CheimaAmmar/remotesign-lab/document-test.txt

Document de test pour la signature électronique
