CheimaAmmar/remotesign-lab/hardware/fabrication/schematic.pdf

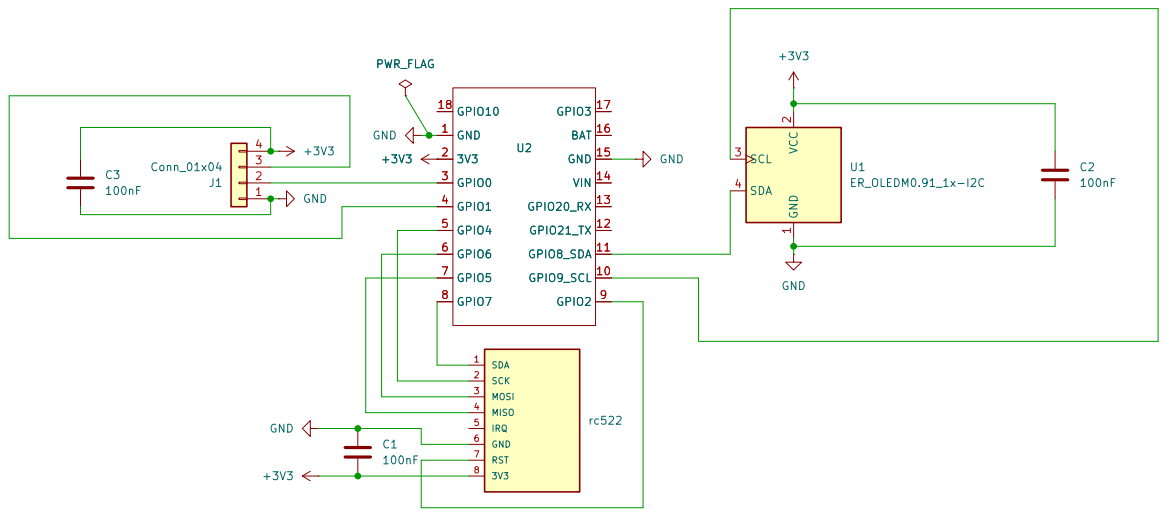
[picture p6: page 1]

Size: A4 | Rev:
KiCad E.D.A. 10.0.5 | Id: 1/1
