CheimaAmmar/remotesign-lab/hardware/fabrication/copper-layout-inverted.pdf

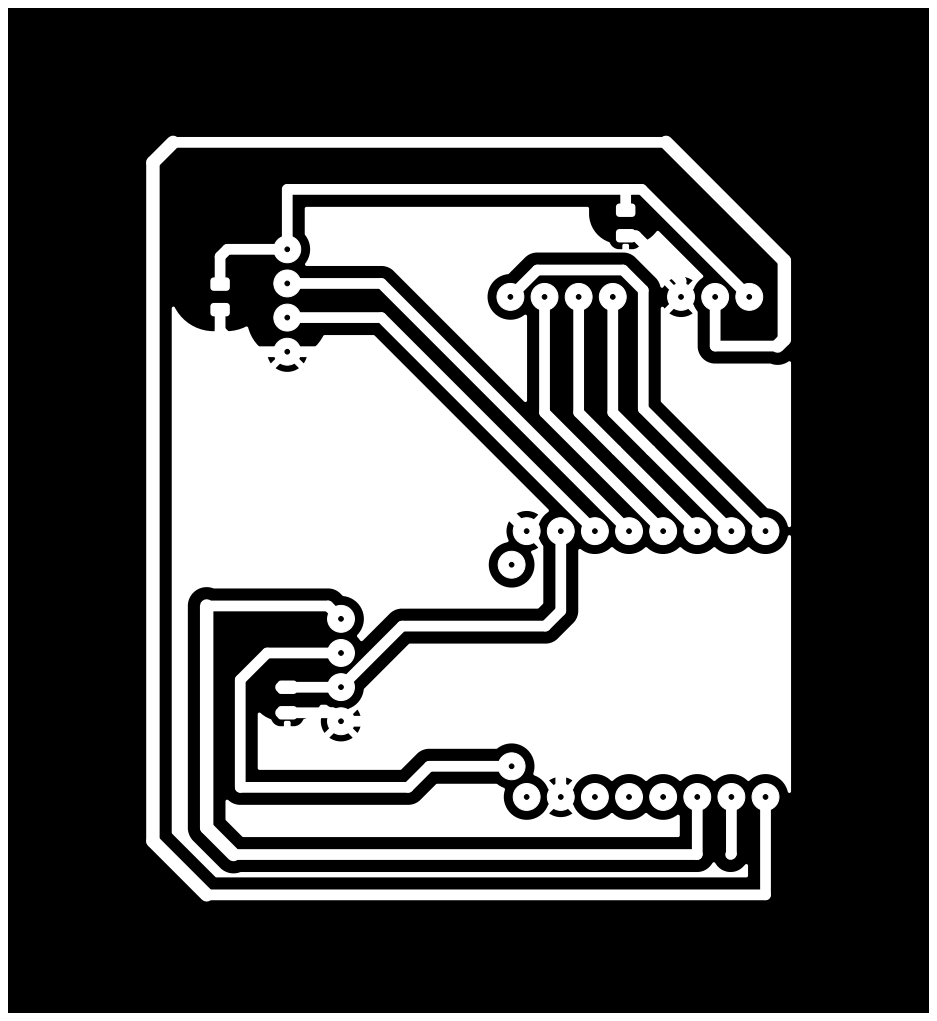
[picture p7: page 1]
