CheimaAmmar/remotesign-lab/hardware/kicad/remotesign_lab.kicad_pcb

## KiCad design hardware/kicad/remotesign_lab.kicad_pcb (2026-09-13)

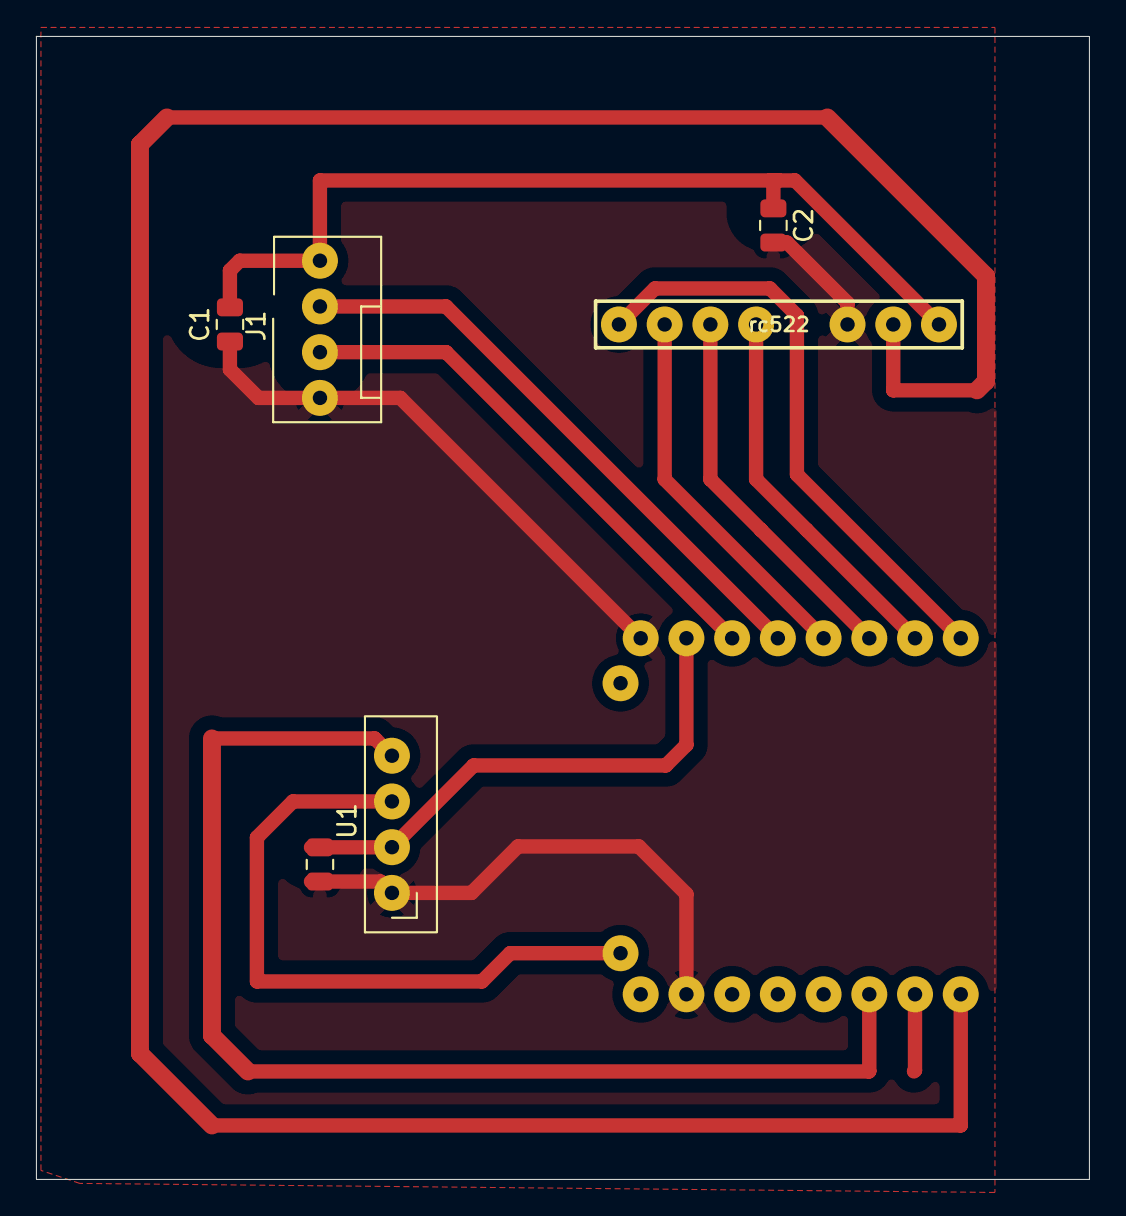
[picture p8: board remotesign_lab.kicad_pcb from above]

Board: 2 copper layers, 58.5 x 63.5 mm, 7 parts (0 on the bottom side), 11 nets.

Parts:
C1, C2, C3: 100nF; C_0805_2012Metric
J1: Conn_01x04; FanPinHeader_1x04_P2.54mm_Vertical
U1: ER_OLEDM0.91_1x-I2C
U2: BEETLE_ESP32_C3_DFR0868
rc522: RFID-RC522

Connections:
+3V3: C1.2, C2.1, C3.1, J1.4, U1.2 (VCC), U2.2 (3V3), rc522.8 (3V3)
GND: C1.1, C2.2, C3.2, J1.1, U1.1 (GND), U2.1 (GND), U2.15 (GND), rc522.6 (GND)
unnamed: J1.2, U2.3 (GPIO0)
unnamed: J1.3, U2.4 (GPIO1)
unnamed: U1.3 (SCL), U2.17 (GPIO3)
unnamed: U1.4 (SDA), U2.11 (GPIO8_SDA)
unnamed: U2.9 (GPIO2), rc522.7 (RST)
unnamed: U2.5 (GPIO4), rc522.2 (SCK)
unnamed: U2.7 (GPIO5), rc522.4 (MISO)
unnamed: U2.6 (GPIO6), rc522.3 (MOSI)
unnamed: U2.8 (GPIO7), rc522.1 (SDA)
