CheimaAmmar/remotesign-lab/app/services/signature_request_service.py

import logging
import uuid

from datetime import datetime, timedelta, timezone

from sqlalchemy import func, select, update
from sqlalchemy.exc import SQLAlchemyError
from sqlalchemy.orm import Session

from app.models import (
    AuthenticationSession,
    Device,
    Document,
    DocumentSignature,
    SignatureRequest,
    SignatureRequestStatus,
)


logger = logging.getLogger(__name__)

SIGNATURE_REQUEST_TTL_SECONDS = 15 * 60

EXPIRABLE_SIGNATURE_REQUEST_STATUSES = (
    SignatureRequestStatus.PENDING,
    SignatureRequestStatus.CLAIMED,
)


def utc_now() -> datetime:
    return datetime.now(timezone.utc)


def _device_queue_lock_key(device_id: uuid.UUID) -> int:
    # PostgreSQL advisory locks accept a signed BIGINT. UUID entropy is
    # retained in the low 63 bits without risking an integer overflow.
    return device_id.int & ((1 << 63) - 1)


def _expire_if_needed(
    signature_request: SignatureRequest,
    *,
    now: datetime,
    database: Session | None = None,
) -> bool:
    if (
        signature_request.status
        not in EXPIRABLE_SIGNATURE_REQUEST_STATUSES
        or signature_request.expires_at > now
    ):
        return False

    signature_request.status = SignatureRequestStatus.EXPIRED
    signature_request.failure_detail = (
        "Signature request expired"
    )
    signature_request.completed_at = now
    signature_request.updated_at = now

    if database is not None:
        # Local import keeps the queue service independent at import time
        # while ensuring expiration and its audit evidence share one
        # transaction.
        from app.services.audit_service import add_audit_event

        add_audit_event(
            database,
            event_type="SIGNATURE_REQUEST_EXPIRED",
            outcome="FAILURE",
            actor_type="SYSTEM",
            user_id=signature_request.user_id,
            device_id=signature_request.device_id,
            document_id=signature_request.document_id,
            signature_request_id=signature_request.id,
            failure_code="REQUEST_EXPIRED",
            detail="Signature request expired",
        )

    return True


def create_signature_request(
    database: Session,
    *,
    owner_session_id: str,
    user_id: uuid.UUID,
    device: Device,
    document: Document,
    consented_at: datetime | None = None,
    consent_version: str | None = None,
) -> SignatureRequest:
    document_user_id = getattr(document, "user_id", None)

    if (
        document_user_id is not None
        and document_user_id != user_id
    ):
        raise ValueError(
            "Document does not belong to the requesting user"
        )

    now = utc_now()
    signature_request = SignatureRequest(
        owner_session_id=owner_session_id,
        user_id=user_id,
        device_id=device.id,
        document_id=document.id,
        document_hash=document.document_hash,
        decision="APPROVE",
        consented_at=consented_at,
        consent_version=consent_version,
        status=SignatureRequestStatus.PENDING,
        expires_at=(
            now
            + timedelta(
                seconds=SIGNATURE_REQUEST_TTL_SECONDS
            )
        ),
        updated_at=now,
    )

    database.add(signature_request)

    return signature_request


def expire_signature_requests(
    database: Session,
    *,
    device_id: uuid.UUID | None = None,
    now: datetime | None = None,
) -> int:
    current_time = now or utc_now()
    conditions = [
        SignatureRequest.status.in_(
            EXPIRABLE_SIGNATURE_REQUEST_STATUSES
        ),
        SignatureRequest.expires_at <= current_time,
    ]

    if device_id is not None:
        conditions.append(
            SignatureRequest.device_id == device_id
        )

    if isinstance(database, Session):
        expired_requests = list(
            database.scalars(
                select(SignatureRequest)
                .where(*conditions)
                .order_by(
                    SignatureRequest.created_at.asc(),
                    SignatureRequest.id.asc(),
                )
                .with_for_update(skip_locked=True)
            ).all()
        )

        for signature_request in expired_requests:
            _expire_if_needed(
                signature_request,
                now=current_time,
                database=database,
            )

        return len(expired_requests)

    # Lightweight compatibility path for isolated unit-test doubles.
    result = database.execute(
        update(SignatureRequest)
        .where(*conditions)
        .values(
            status=SignatureRequestStatus.EXPIRED,
            failure_detail="Signature request expired",
            completed_at=current_time,
            updated_at=current_time,
        )
    )

    return int(result.rowcount or 0)


def claim_next_signature_request(
    database: Session,
    *,
    device: Device,
) -> SignatureRequest | None:
    now = utc_now()

    # Serializes queue pollers for one physical device without locking
    # the devices row also updated by the existing authentication flows.
    # The lock is released automatically with this transaction.
    database.execute(
        select(
            func.pg_advisory_xact_lock(
                _device_queue_lock_key(device.id)
            )
        )
    )

    expire_signature_requests(
        database,
        device_id=device.id,
        now=now,
    )

    in_flight_request = database.scalar(
        select(SignatureRequest)
        .where(
            SignatureRequest.device_id == device.id,
            SignatureRequest.status.in_(
                (
                    SignatureRequestStatus.CLAIMED,
                    SignatureRequestStatus.AUTHENTICATING,
                    SignatureRequestStatus.AUTHENTICATED,
                )
            ),
        )
        .order_by(
            SignatureRequest.claimed_at.asc(),
            SignatureRequest.created_at.asc(),
            SignatureRequest.id.asc(),
        )
        .with_for_update()
        .limit(1)
    )

    if in_flight_request is not None:
        # Never deliver a CLAIMED request a second time. The device must
        # finish or explicitly fail its current request before polling the
        # next FIFO item.
        return None

    signature_request = database.scalar(
        select(SignatureRequest)
        .where(
            SignatureRequest.device_id == device.id,
            SignatureRequest.status
            == SignatureRequestStatus.PENDING,
            SignatureRequest.expires_at > now,
        )
        .order_by(
            SignatureRequest.created_at.asc(),
            SignatureRequest.id.asc(),
        )
        .with_for_update(skip_locked=True)
        .limit(1)
    )

    if signature_request is None:
        return None

    signature_request.status = SignatureRequestStatus.CLAIMED
    signature_request.claimed_at = now
    signature_request.updated_at = now

    return signature_request


def get_owned_signature_request(
    database: Session,
    *,
    request_id: uuid.UUID,
    owner_session_id: str,
) -> SignatureRequest | None:
    signature_request = database.scalar(
        select(SignatureRequest)
        .where(
            SignatureRequest.id == request_id,
            SignatureRequest.owner_session_id
            == owner_session_id,
        )
        .with_for_update()
    )

    if signature_request is None:
        return None

    now = utc_now()

    _expire_if_needed(
        signature_request,
        now=now,
        database=database,
    )

    return signature_request


def get_user_signature_request(
    database: Session,
    *,
    request_id: uuid.UUID,
    user_id: uuid.UUID,
) -> SignatureRequest | None:
    signature_request = database.scalar(
        select(SignatureRequest)
        .where(
            SignatureRequest.id == request_id,
            SignatureRequest.user_id == user_id,
        )
        .with_for_update()
    )

    if signature_request is None:
        return None

    _expire_if_needed(
        signature_request,
        now=utc_now(),
        database=database,
    )

    return signature_request


def get_latest_signature_request_for_document(
    database: Session,
    *,
    document_id: uuid.UUID,
) -> SignatureRequest | None:
    """Return the latest request for ADMIN read-only monitoring."""
    signature_request = database.scalar(
        select(SignatureRequest)
        .where(
            SignatureRequest.document_id == document_id,
        )
        .order_by(
            SignatureRequest.created_at.desc(),
            SignatureRequest.id.desc(),
        )
        .limit(1)
    )

    return signature_request


def attach_authentication_session(
    database: Session,
    *,
    device_id: uuid.UUID,
    document_id: uuid.UUID,
    document_hash: str,
    decision: str,
    authentication_session: AuthenticationSession,
) -> SignatureRequest | None:
    now = utc_now()

    if (
        authentication_session.device_id != device_id
        or authentication_session.document_id != document_id
        or authentication_session.document_hash != document_hash
        or authentication_session.decision != decision
    ):
        return None

    signature_request = database.scalar(
        select(SignatureRequest)
        .where(
            SignatureRequest.device_id == device_id,
            SignatureRequest.document_id == document_id,
            SignatureRequest.document_hash == document_hash,
            SignatureRequest.decision == decision,
            SignatureRequest.status.in_(
                (
                    SignatureRequestStatus.CLAIMED,
                )
            ),
            SignatureRequest.authentication_session_id.is_(
                None
            ),
        )
        .order_by(
            SignatureRequest.claimed_at.asc(),
            SignatureRequest.created_at.asc(),
        )
        .with_for_update()
        .limit(1)
    )

    if signature_request is None:
        return None

    if _expire_if_needed(
        signature_request,
        now=now,
        database=database,
    ):
        return signature_request

    signature_request.authentication_session_id = (
        authentication_session.id
    )
    signature_request.status = (
        SignatureRequestStatus.AUTHENTICATING
    )
    signature_request.authentication_started_at = now
    signature_request.updated_at = now

    return signature_request


def mark_signature_request_authenticated(
    database: Session,
    *,
    authentication_session_id: uuid.UUID,
) -> SignatureRequest | None:
    signature_request = database.scalar(
        select(SignatureRequest)
        .where(
            SignatureRequest.authentication_session_id
            == authentication_session_id,
        )
        .with_for_update()
    )

    if signature_request is None:
        return None

    now = utc_now()

    if _expire_if_needed(
        signature_request,
        now=now,
        database=database,
    ):
        return signature_request

    if (
        signature_request.status
        == SignatureRequestStatus.AUTHENTICATING
    ):
        signature_request.status = (
            SignatureRequestStatus.AUTHENTICATED
        )
        signature_request.authenticated_at = now
        signature_request.updated_at = now

    return signature_request


def mark_signature_request_signed(
    database: Session,
    *,
    authentication_session_id: uuid.UUID,
    signature: DocumentSignature,
) -> SignatureRequest | None:
    signature_request = database.scalar(
        select(SignatureRequest)
        .where(
            SignatureRequest.authentication_session_id
            == authentication_session_id,
        )
        .with_for_update()
    )

    if signature_request is None:
        return None

    if (
        signature.session_id != authentication_session_id
        or signature_request.document_id
        != signature.document_id
        or signature_request.device_id != signature.device_id
        or signature_request.document_hash
        != signature.document_hash
    ):
        return signature_request

    now = utc_now()

    if _expire_if_needed(
        signature_request,
        now=now,
        database=database,
    ):
        return signature_request

    if (
        signature_request.status
        == SignatureRequestStatus.AUTHENTICATED
    ):
        signature_request.status = SignatureRequestStatus.SIGNED
        signature_request.signature_id = signature.id
        signature_request.completed_at = now
        signature_request.updated_at = now

    return signature_request


def mark_signature_request_failed(
    database: Session,
    *,
    request_id: uuid.UUID,
    device_id: uuid.UUID,
    failure_detail: str,
) -> SignatureRequest | None:
    signature_request = database.scalar(
        select(SignatureRequest)
        .where(
            SignatureRequest.id == request_id,
            SignatureRequest.device_id == device_id,
        )
        .with_for_update()
    )

    if signature_request is None:
        return None

    now = utc_now()

    if _expire_if_needed(
        signature_request,
        now=now,
        database=database,
    ):
        return signature_request

    if signature_request.status in (
        SignatureRequestStatus.CLAIMED,
        SignatureRequestStatus.AUTHENTICATING,
        SignatureRequestStatus.AUTHENTICATED,
    ):
        signature_request.status = SignatureRequestStatus.FAILED
        signature_request.failure_detail = failure_detail[:255]
        signature_request.completed_at = now
        signature_request.updated_at = now

    return signature_request


def mark_signature_request_failed_by_session(
    database: Session,
    *,
    authentication_session_id: uuid.UUID,
    failure_detail: str,
) -> SignatureRequest | None:
    signature_request = database.scalar(
        select(SignatureRequest)
        .where(
            SignatureRequest.authentication_session_id
            == authentication_session_id,
        )
        .with_for_update()
    )

    if signature_request is None:
        return None

    now = utc_now()

    if _expire_if_needed(
        signature_request,
        now=now,
        database=database,
    ):
        return signature_request

    if signature_request.status in (
        SignatureRequestStatus.AUTHENTICATING,
        SignatureRequestStatus.AUTHENTICATED,
    ):
        signature_request.status = SignatureRequestStatus.FAILED
        signature_request.failure_detail = failure_detail[:255]
        signature_request.completed_at = now
        signature_request.updated_at = now

    return signature_request


def persist_terminal_signature_request_failure(
    database: Session,
    *,
    authentication_session_id: uuid.UUID,
    failure_detail: str,
) -> None:
    """Persist a terminal queue failure after an API rejection rollback."""
    try:
        mark_signature_request_failed_by_session(
            database,
            authentication_session_id=(
                authentication_session_id
            ),
            failure_detail=failure_detail,
        )
        database.commit()

    except SQLAlchemyError:
        database.rollback()
        logger.exception(
            "Unable to persist the terminal signature queue failure"
        )


def _run_optional_queue_hook(
    database: Session,
    operation,
) -> object | None:
    result = None

    try:
        with database.begin_nested():
            result = operation()

    except SQLAlchemyError as error:
        original_error = getattr(error, "orig", None)
        sqlstate = (
            getattr(original_error, "sqlstate", None)
            or getattr(original_error, "pgcode", None)
        )

        # Preserve the legacy device routes only during the short window
        # before this revision's table has been migrated. Any other queue
        # database error must abort the surrounding auth/sign transaction
        # instead of silently leaving its state behind.
        if sqlstate not in ("42P01", "42703"):
            raise

        logger.warning(
            "Signature queue schema is not migrated yet; "
            "skipping state synchronization"
        )

    return result


def signature_request_is_authorized_for_session(
    database: Session,
    *,
    authentication_session: AuthenticationSession,
    expected_status: SignatureRequestStatus,
) -> bool:
    authorized = False

    def check_authorization() -> None:
        nonlocal authorized
        signature_request = database.scalar(
            select(SignatureRequest)
            .where(
                SignatureRequest.authentication_session_id
                == authentication_session.id,
            )
            .with_for_update()
        )

        if signature_request is None:
            return

        now = utc_now()
        consent_version = signature_request.consent_version
        authorized = (
            signature_request.status == expected_status
            and signature_request.expires_at > now
            and signature_request.user_id is not None
            and signature_request.user_id
            == authentication_session.user_id
            and signature_request.consented_at is not None
            and isinstance(consent_version, str)
            and bool(consent_version.strip())
            and signature_request.device_id
            == authentication_session.device_id
            and signature_request.document_id
            == authentication_session.document_id
            and signature_request.document_hash
            == authentication_session.document_hash
            and signature_request.decision
            == authentication_session.decision
        )

    _run_optional_queue_hook(database, check_authorization)

    return authorized


def try_attach_authentication_session(
    database: Session,
    **kwargs,
) -> SignatureRequest | None:
    result = _run_optional_queue_hook(
        database,
        lambda: attach_authentication_session(
            database,
            **kwargs,
        ),
    )

    return result if isinstance(result, SignatureRequest) else None


def try_mark_signature_request_authenticated(
    database: Session,
    *,
    authentication_session_id: uuid.UUID,
) -> SignatureRequest | None:
    result = _run_optional_queue_hook(
        database,
        lambda: mark_signature_request_authenticated(
            database,
            authentication_session_id=(
                authentication_session_id
            ),
        ),
    )

    return result if isinstance(result, SignatureRequest) else None


def try_mark_signature_request_signed(
    database: Session,
    *,
    authentication_session_id: uuid.UUID,
    signature: DocumentSignature,
) -> SignatureRequest | None:
    result = _run_optional_queue_hook(
        database,
        lambda: mark_signature_request_signed(
            database,
            authentication_session_id=(
                authentication_session_id
            ),
            signature=signature,
        ),
    )

    return result if isinstance(result, SignatureRequest) else None
