CheimaAmmar/remotesign-lab/(commit log)

2026-08-26 Initial commit - stage HSM server
2026-09-03 Complete Stage-HSM web to ESP32 signing workflow
2026-09-05 Stabilize Stage-HSM signing workflow and admin user separation
    [document_service.py]
2026-09-13 Document hardware prototype and PCB fabrication
    [remotesign_lab.kicad_pcb, remotesign_lab.kicad_sch]
